JonasNorling/knobbox/hw/knobboard-round/encoders2.sch

## KiCad design hw/knobboard-round/encoders2.sch (2015-05-10)

Schematic: encoders2.sch

Parts:
C23, C25: 100n
C24: 10u
ENC5, ENC6, ENC7, ENC8: PEL12D
RK52, RK53, RK62, RK63, RK72, RK73, RK82, RK83: 390
RPU13, RPU14, RPU15, RPU16, RPU17, RPU18, RPU19, RPU20, RPU21, RPU22, RPU23, RPU24: 20k
U7: 74HCT595
U9: 74HC165

Notes on the sheet:
PEL12D green/red max 30mA. Vf is 3.2/1.95V. Driven at 8mA, resistors should be 225/381 ohms. terminal 2 is green, terminal 3 is red.
NXP 74HCT595 will source up to 8mA to each output and seems to be 5V/3V compatible.
Needs to be 5V/3V compatible --> use HCT
