JonasNorling/knobbox/hw/knobboard-round/encoders3.sch

## KiCad design hw/knobboard-round/encoders3.sch (2015-05-10)

Schematic: encoders3.sch

Parts:
C30, C32: 100n
C31: 10u
ENC9, ENC10, ENC11, ENC12: PEL12D
RK92, RK93, RK102, RK103, RK112, RK113, RK122, RK123: 390
RPU37, RPU38, RPU39, RPU40, RPU41, RPU42, RPU43, RPU44, RPU45, RPU46, RPU47, RPU48: 20k
U13: 74HCT595
U14: 74HC165

Notes on the sheet:
PEL12D green/red max 30mA. Vf is 3.2/1.95V. Driven at 8mA, resistors should be 225/381 ohms. terminal 2 is green, terminal 3 is red.
NXP 74HCT595 will source up to 8mA to each output and seems to be 5V/3V compatible.
Needs to be 5V/3V compatible --> use HCT
