JonasNorling/knobbox/hw/knobboard-round/encoders4.sch

## KiCad design hw/knobboard-round/encoders4.sch (2015-05-10)

Schematic: encoders4.sch

Parts:
C27, C29: 100n
C28: 10u
ENC13, ENC14, ENC15, ENC16: PEL12D
RK132, RK133, RK142, RK143, RK152, RK153, RK162, RK163: 390
RPU25, RPU26, RPU27, RPU28, RPU29, RPU30, RPU31, RPU32, RPU33, RPU34, RPU35, RPU36: 20k
U11: 74HCT595
U12: 74HC165

Notes on the sheet:
PEL12D green/red max 30mA. Vf is 3.2/1.95V. Driven at 8mA, resistors should be 225/381 ohms. terminal 2 is green, terminal 3 is red.
NXP 74HCT595 will source up to 8mA to each output and seems to be 5V/3V compatible.
Needs to be 5V/3V compatible --> use HCT
