JonasNorling/knobbox/hw/knobboard-round/encoders.sch

## KiCad design hw/knobboard-round/encoders.sch (2015-05-10)

Schematic: encoders.sch

Parts:
C6, C11: 100n
C16: 10u
ENC1, ENC2, ENC3, ENC4: PEL12D
RK12, RK13, RK22, RK23, RK32, RK33, RK42, RK43: 390
RPU1, RPU5, RPU6, RPU7, RPU8, RPU9, RPU10, RPU11, RPU12: 20k
U3: 74HCT595
U8: 74HC165

Notes on the sheet:
PEL12D green/red max 30mA. Vf is 3.2/1.95V. Driven at 8mA, resistors should be 225/381 ohms. terminal 2 is green, terminal 3 is red.
NXP 74HCT595 will source up to 8mA to each output and seems to be 5V/3V compatible.
Needs to be 5V/3V compatible --> use HCT
