JonasNorling/knobbox/hw/knobboard-round/flash.sch

## KiCad design hw/knobboard-round/flash.sch (2015-05-10)

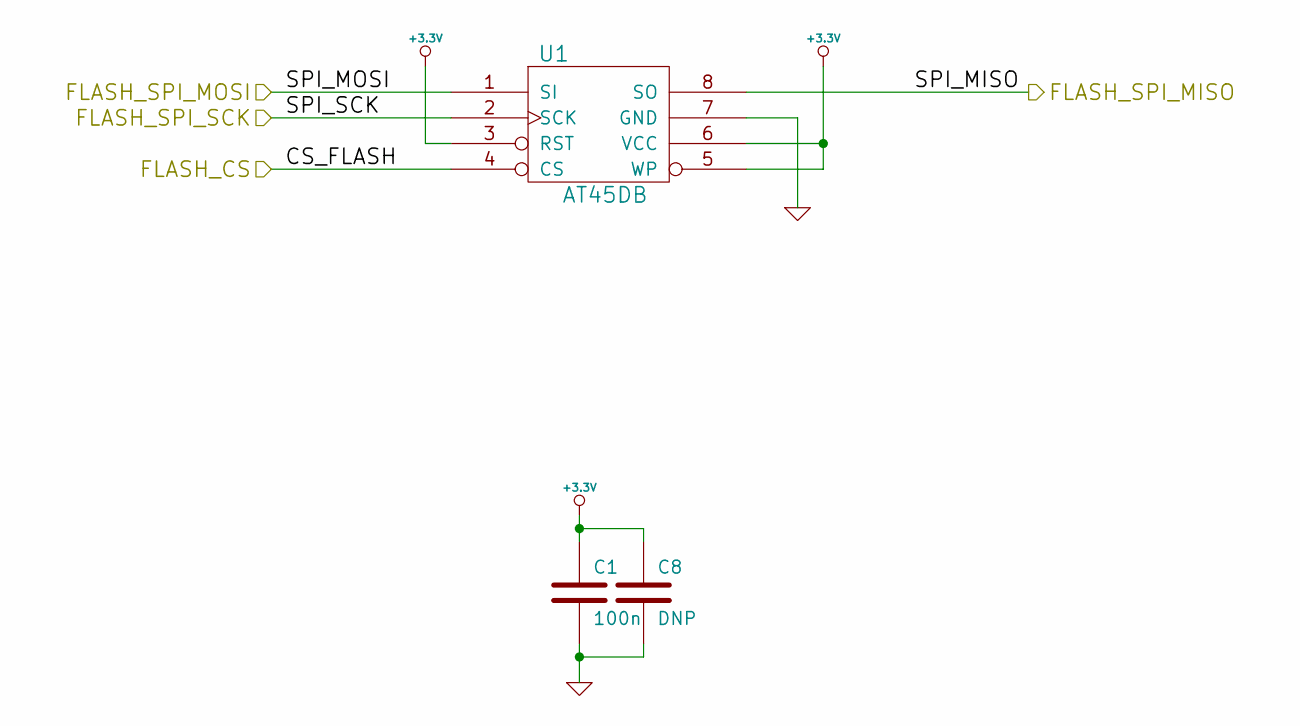
[picture p1: schematic flash.sch]

Parts:
C1: 100n
C8: DNP
U1: AT45DB

Connections:
+3.3V: C1.1, C8.1, U1.3 (RST), U1.5 (WP), U1.6 (VCC)
CS_FLASH: U1.4 (CS)
FLASH_SPI_MISO: U1.8 (SO)
FLASH_SPI_MOSI: U1.1 (SI)
FLASH_SPI_SCK: U1.2 (SCK)
GND: C1.2, C8.2, U1.7 (GND)
