JonasNorling/knobbox/hw/knobboard-round/io.sch

## KiCad design hw/knobboard-round/io.sch (2015-05-10)

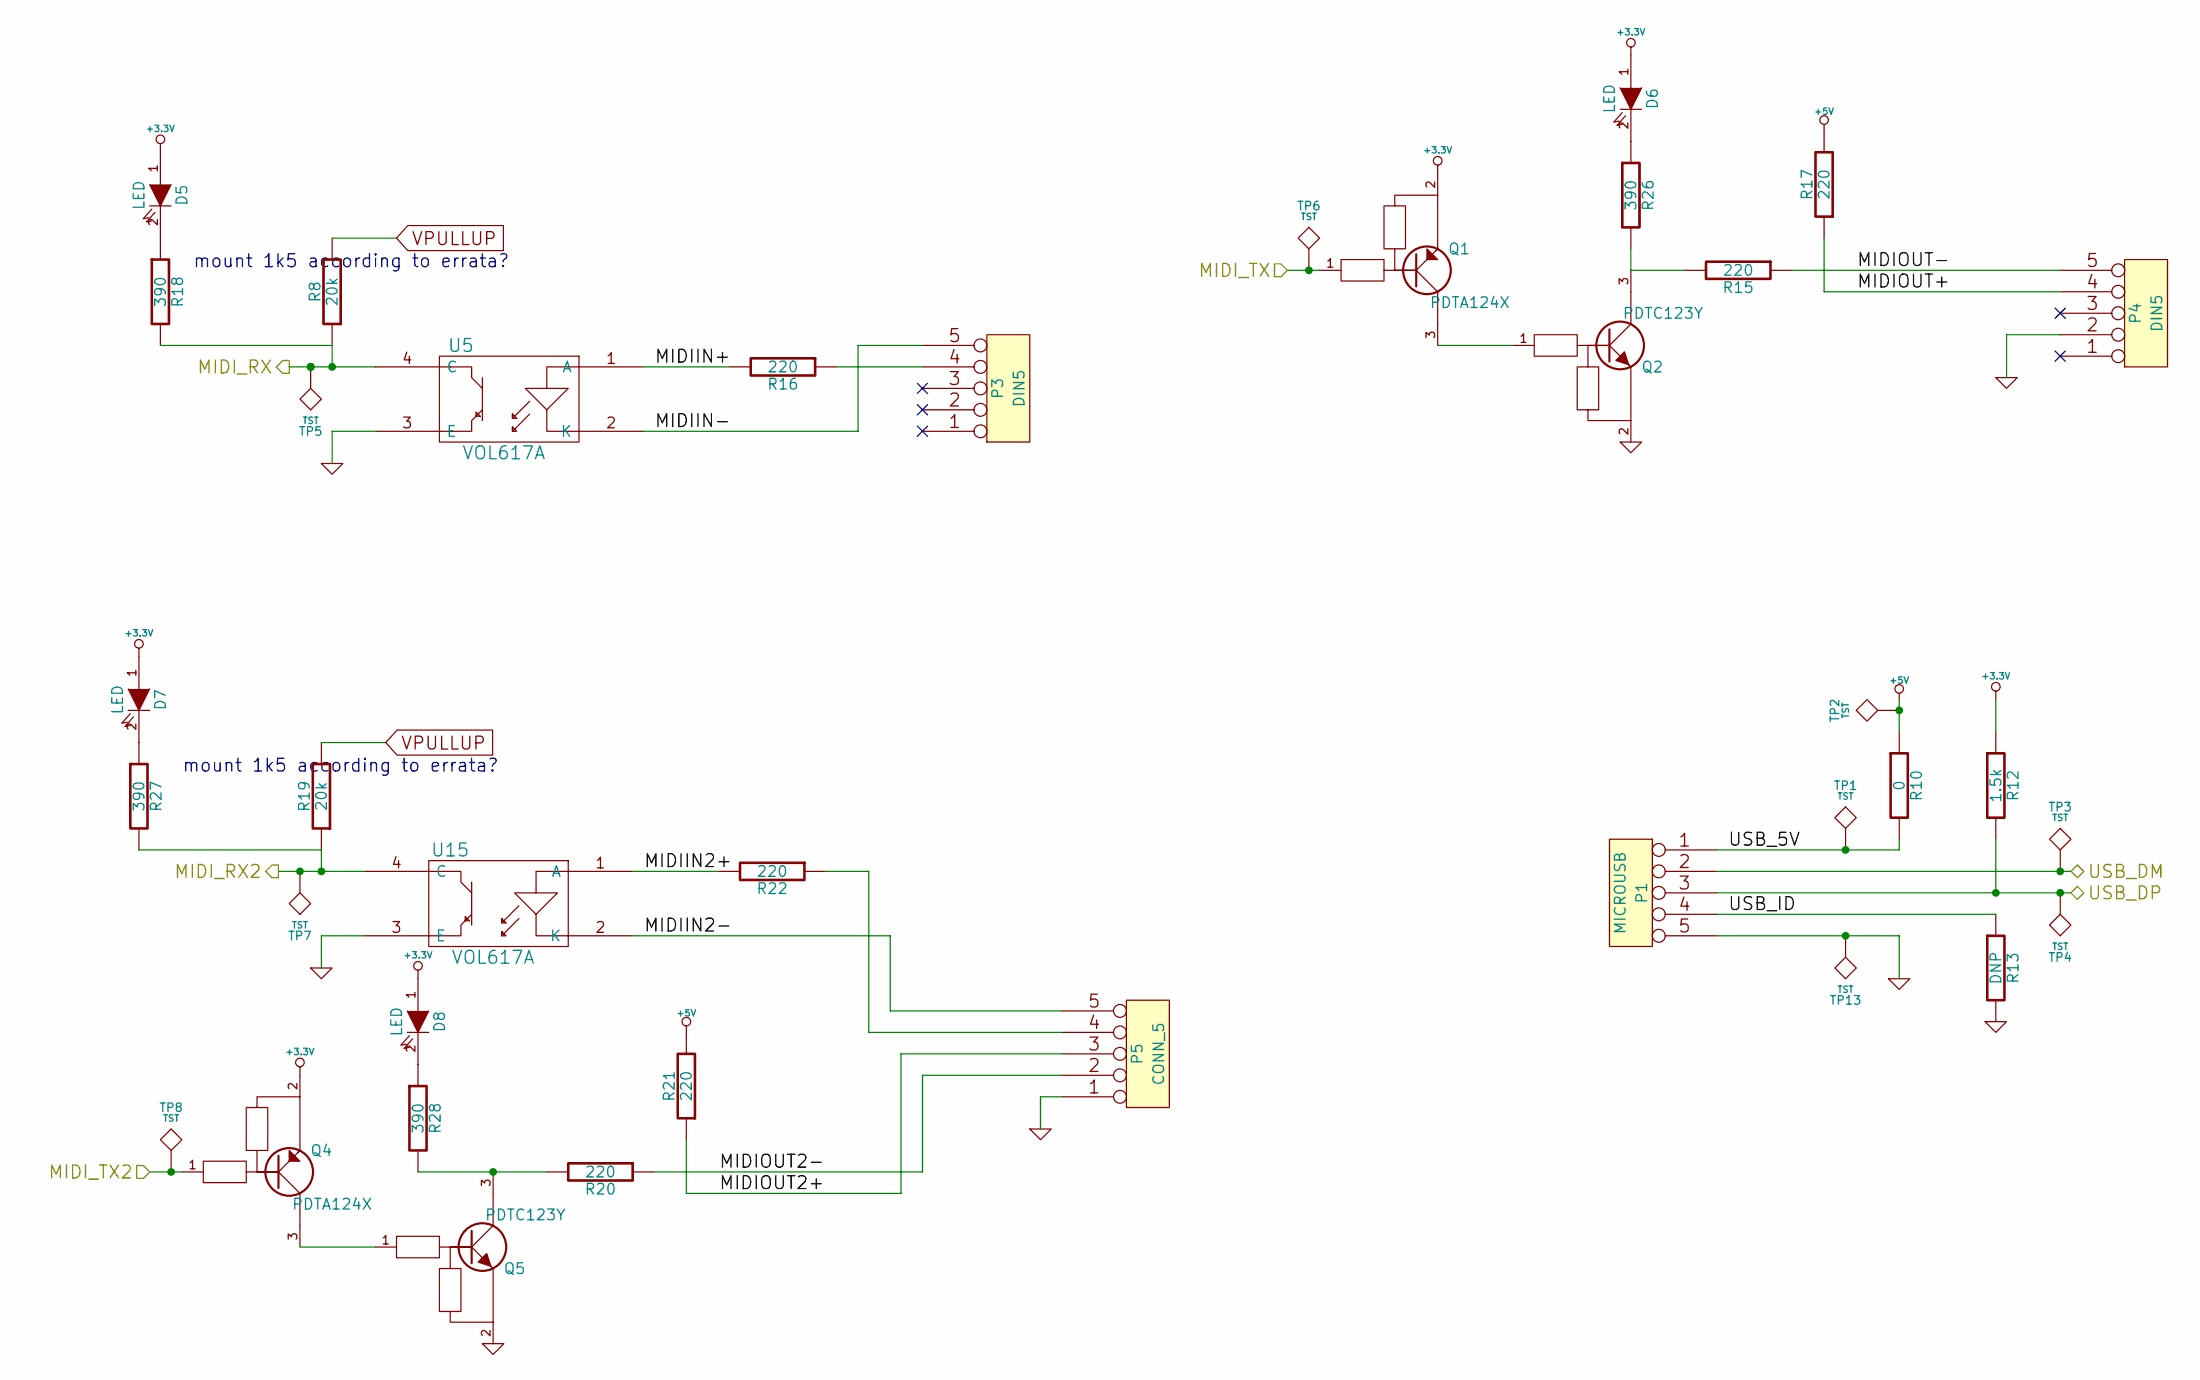
[picture p2: schematic io.sch]

Parts:
D5, D6, D7, D8: LED
P1: MICROUSB
P3, P4: DIN5
P5: CONN_5
Q1, Q4: PDTA124X; SOT23-3
Q2, Q5: PDTC123Y; SOT23-3
R8, R19: 20k
R10: 0
R12: 1.5k
R13: DNP
R15, R16, R17, R20, R21, R22: 220
R18, R26, R27, R28: 390
TP1, TP2, TP3, TP4, TP5, TP6, TP7, TP8, TP13: TST
U5, U15: VOL617A

Connections:
+3.3V: D5.1 (A), D6.1 (A), D7.1 (A), D8.1 (A), Q1.2 (E), Q4.2 (E), R12.1
+5V: R10.1, R17.2, R21.2, TP2.1
GND: P1.5, P4.2, P5.1, Q2.2 (E), Q5.2 (E), R13.2, TP13.1, U5.3 (E), U15.3 (E)
MIDIIN2+: R22.2, U15.1 (A)
MIDIIN2-: P5.5, U15.2 (K)
MIDIIN+: R16.2, U5.1 (A)
MIDIIN-: P3.5, U5.2 (K)
MIDIOUT2+: P5.3, R21.1
MIDIOUT2-: P5.2, R20.1
MIDIOUT+: P4.4, R17.1
MIDIOUT-: P4.5, R15.1
MIDI_RX: R8.1, R18.2, TP5.1, U5.4 (C)
MIDI_RX2: R19.1, R27.2, TP7.1, U15.4 (C)
MIDI_TX: Q1.1 (B), TP6.1
MIDI_TX2: Q4.1 (B), TP8.1
unnamed: D5.2 (K), R18.1
unnamed: D6.2 (K), R26.1
unnamed: D7.2 (K), R27.1
unnamed: D8.2 (K), R28.1
unnamed: P3.4, R16.1
unnamed: P5.4, R22.1
unnamed: Q1.3 (C), Q2.1 (B)
unnamed: Q2.3 (C), R15.2, R26.2
unnamed: Q4.3 (C), Q5.1 (B)
unnamed: Q5.3 (C), R20.2, R28.2
USB_5V: P1.1, R10.2, TP1.1
USB_DM: P1.2, TP3.1
USB_DP: P1.3, R12.2, TP4.1
USB_ID: P1.4, R13.1
VPULLUP: R8.2, R19.2

Notes on the sheet:
mount 1k5 according to errata?
