JonasNorling/knobbox/hw/knobboard-round/knobboard.sch

## KiCad design hw/knobboard-round/knobboard.sch (2015-05-10)

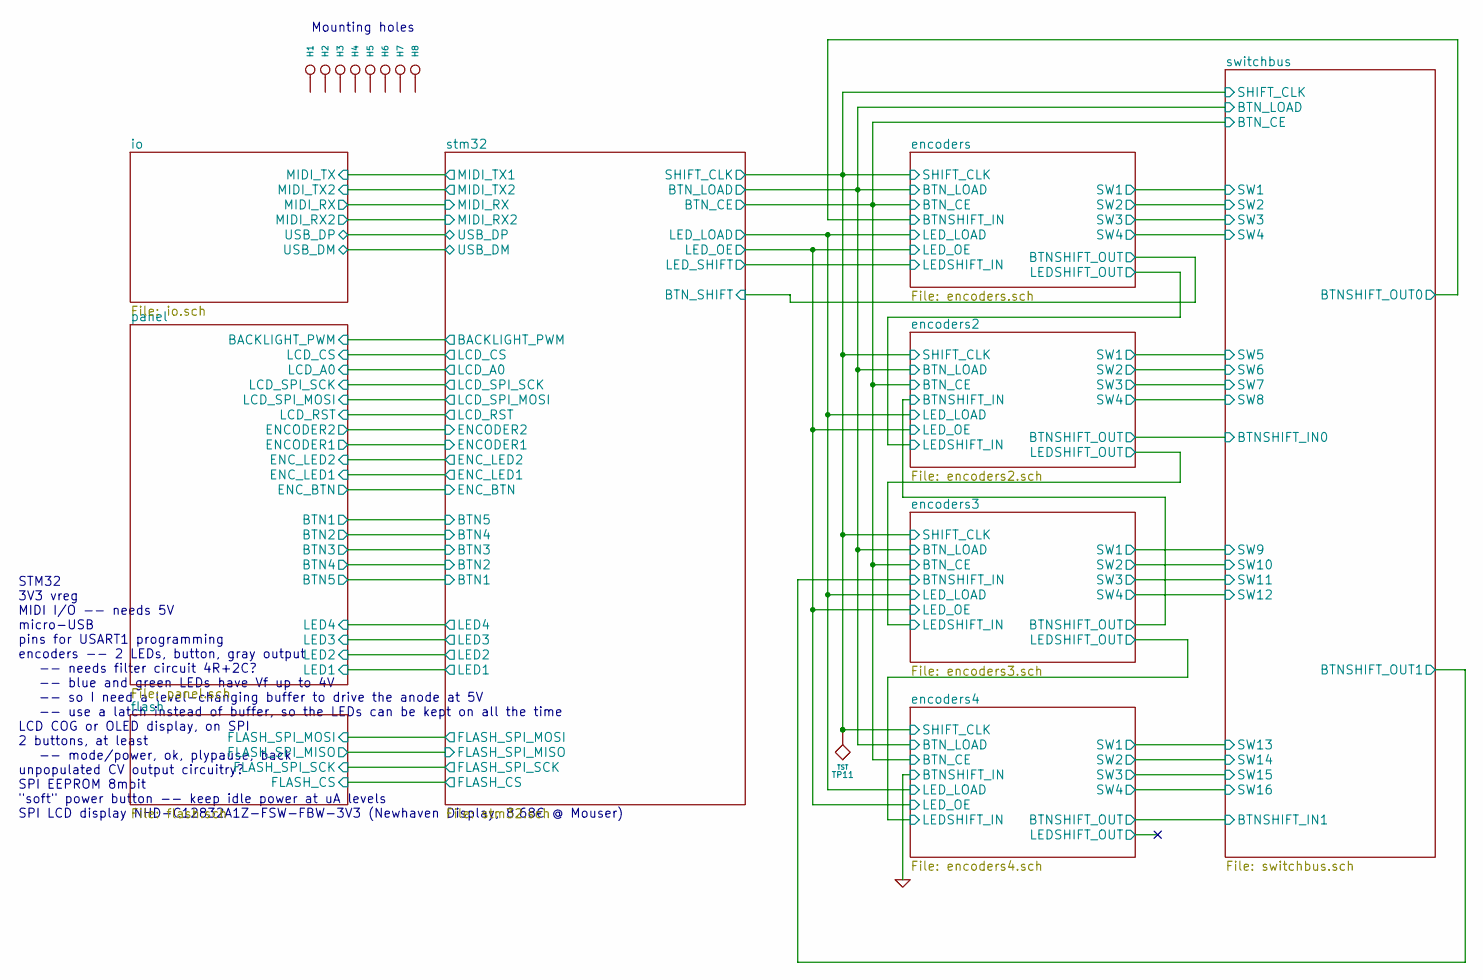
[picture p3: schematic knobboard.sch]

Parts:
H1, H2, H3, H4, H5, H6, H7, H8: CONN_1
TP11: TST

Connections:
SHIFT_CLK: TP11.1

Notes on the sheet:
Mounting holes
STM32 3V3 vreg MIDI I/O -- needs 5V micro-USB pins for USART1 programming encoders -- 2 LEDs, button, gray output -- needs filter circuit 4R+2C? -- blue and green LEDs have Vf up to 4V -- so I need a level-changing buffer to drive the anode at 5V -- use a latch instead of buffer, so the LEDs can be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
