JonasNorling/knobbox/hw/knobboard-round/panel.sch

## KiCad design hw/knobboard-round/panel.sch (2015-05-10)

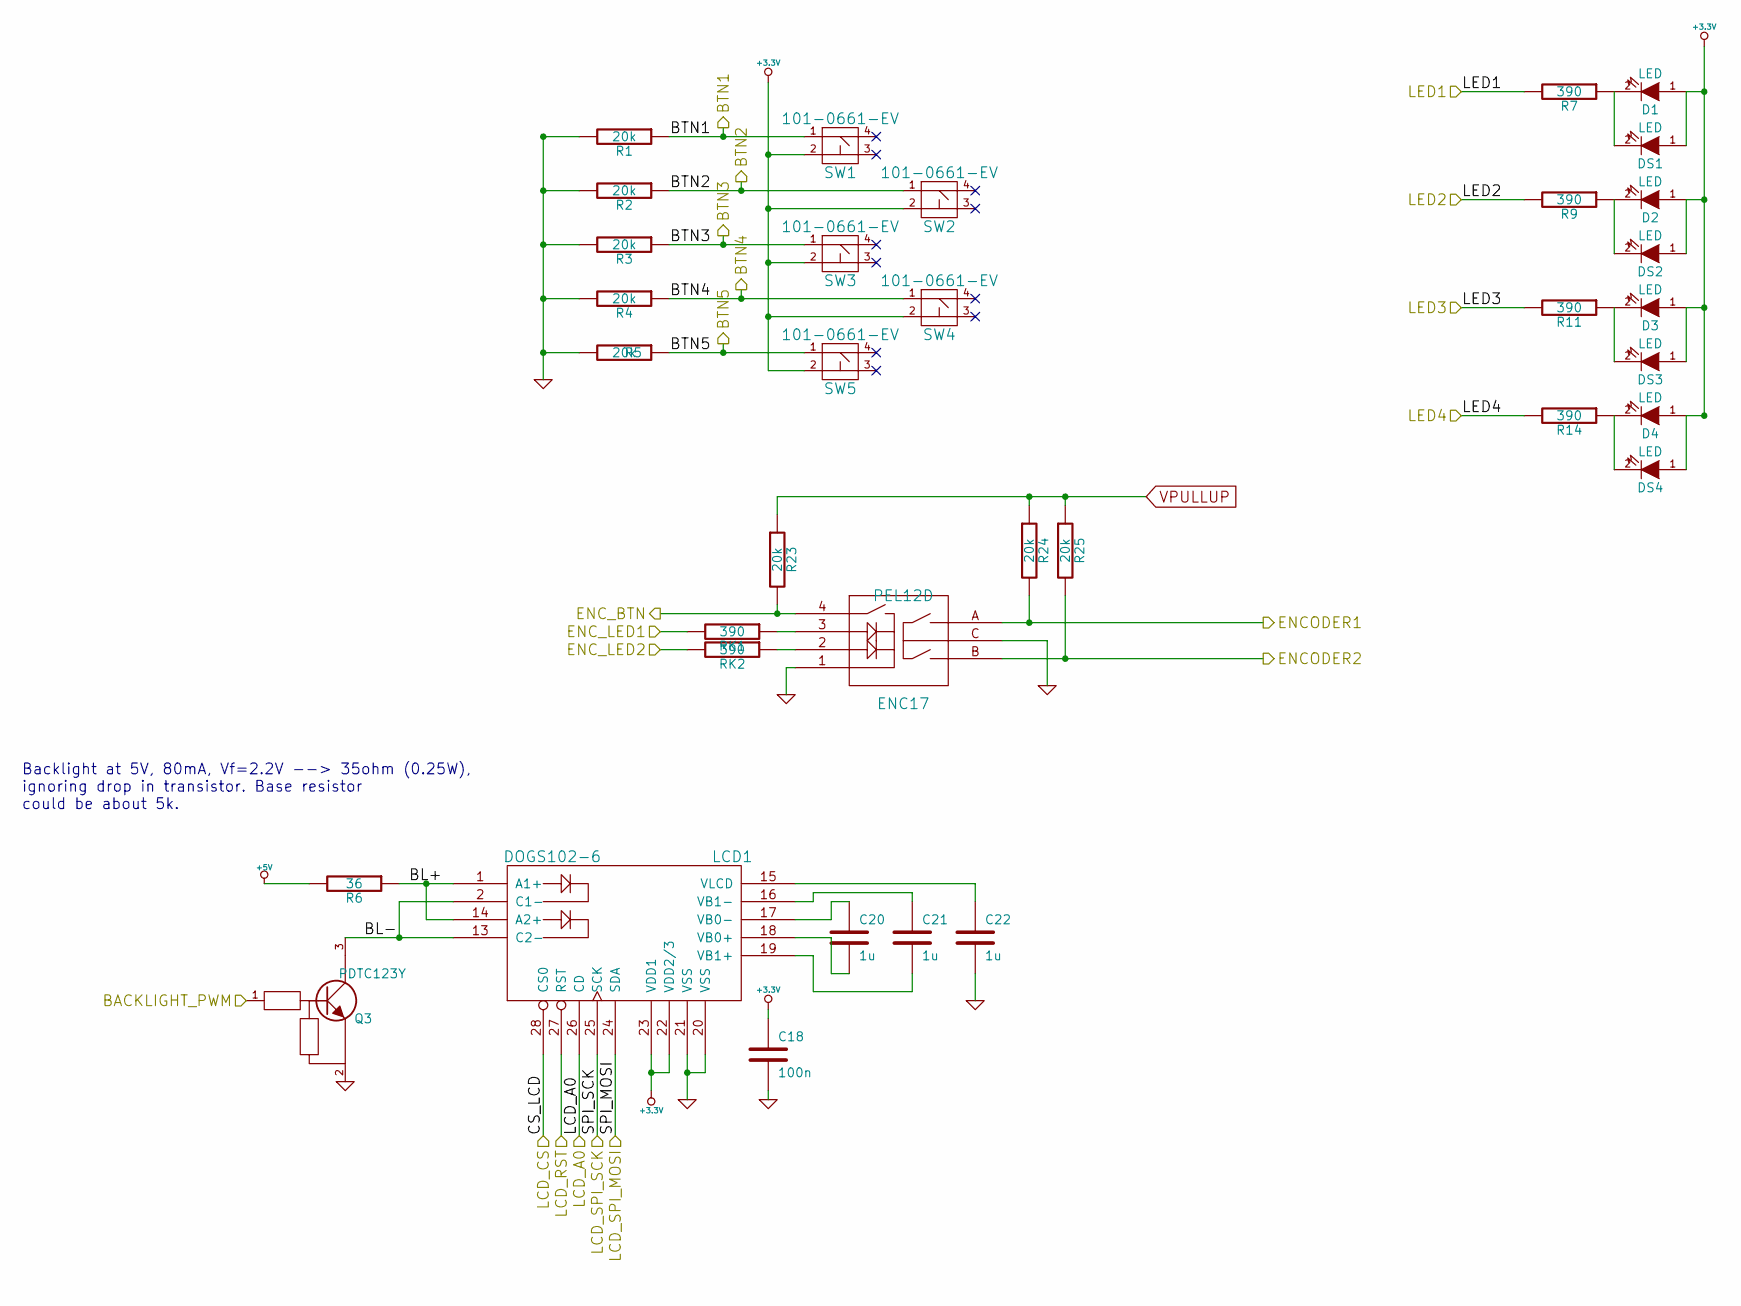
[picture p4: schematic panel.sch]

Parts:
C18: 100n
C20, C21, C22: 1u
D1, D2, D3, D4: LED
DS1, DS2, DS3, DS4: LED
ENC17: PEL12D
LCD1: DOGS102-6
Q3: PDTC123Y; SOT23-3
R1, R2, R3, R4, R5, R23, R24, R25: 20k
R6: 36
R7, R9, R11, R14: 390
RK1, RK2: 390
SW1, SW2, SW3, SW4, SW5: 101-0661-EV

Connections:
+3.3V: C18.1, D1.1 (A), D2.1 (A), D3.1 (A), D4.1 (A), DS1.1 (A), DS2.1 (A), DS3.1 (A), DS4.1 (A), LCD1.22 (VDD2/3), LCD1.23 (VDD1), SW1.2, SW2.2, SW3.2, SW4.2, SW5.2
+5V: R6.2
BACKLIGHT_PWM: Q3.1 (B)
BL+: LCD1.1 (A1+), LCD1.14 (A2+), R6.1
BL-: LCD1.2 (C1-), LCD1.13 (C2-), Q3.3 (C)
BTN1: R1.1, SW1.1
BTN2: R2.1, SW2.1
BTN3: R3.1, SW3.1
BTN4: R4.1, SW4.1
BTN5: R5.1, SW5.1
CS_LCD: LCD1.28 (CS0)
ENCODER1: ENC17.A, R24.2
ENCODER2: ENC17.B, R25.2
ENC_BTN: ENC17.4 (sw), R23.2
ENC_LED1: RK1.2
ENC_LED2: RK2.2
GND: C18.2, C22.2, ENC17.1 (common), ENC17.C, LCD1.20 (VSS), LCD1.21 (VSS), Q3.2 (E), R1.2, R2.2, R3.2, R4.2, R5.2
LCD_A0: LCD1.26 (CD)
LCD_RST: LCD1.27 (RST)
LCD_SPI_MOSI: LCD1.24 (SDA)
LCD_SPI_SCK: LCD1.25 (SCK)
LED1: R7.2
LED2: R9.2
LED3: R11.2
LED4: R14.2
unnamed: C20.1, LCD1.17 (VB0-)
unnamed: C20.2, LCD1.18 (VB0+)
unnamed: C21.1, LCD1.16 (VB1-)
unnamed: C21.2, LCD1.19 (VB1+)
unnamed: C22.1, LCD1.15 (VLCD)
unnamed: D1.2 (K), DS1.2 (K), R7.1
unnamed: D2.2 (K), DS2.2 (K), R9.1
unnamed: D3.2 (K), DS3.2 (K), R11.1
unnamed: D4.2 (K), DS4.2 (K), R14.1
unnamed: ENC17.2 (anode), RK2.1
unnamed: ENC17.3 (anode), RK1.1
VPULLUP: R23.1, R24.1, R25.1

Notes on the sheet:
Backlight at 5V, 80mA, Vf=2.2V --> 35ohm (0.25W), ignoring drop in transistor. Base resistor could be about 5k.
