JonasNorling/knobbox/hw/knobboard-round/stm32.sch

## KiCad design hw/knobboard-round/stm32.sch (2015-05-10)

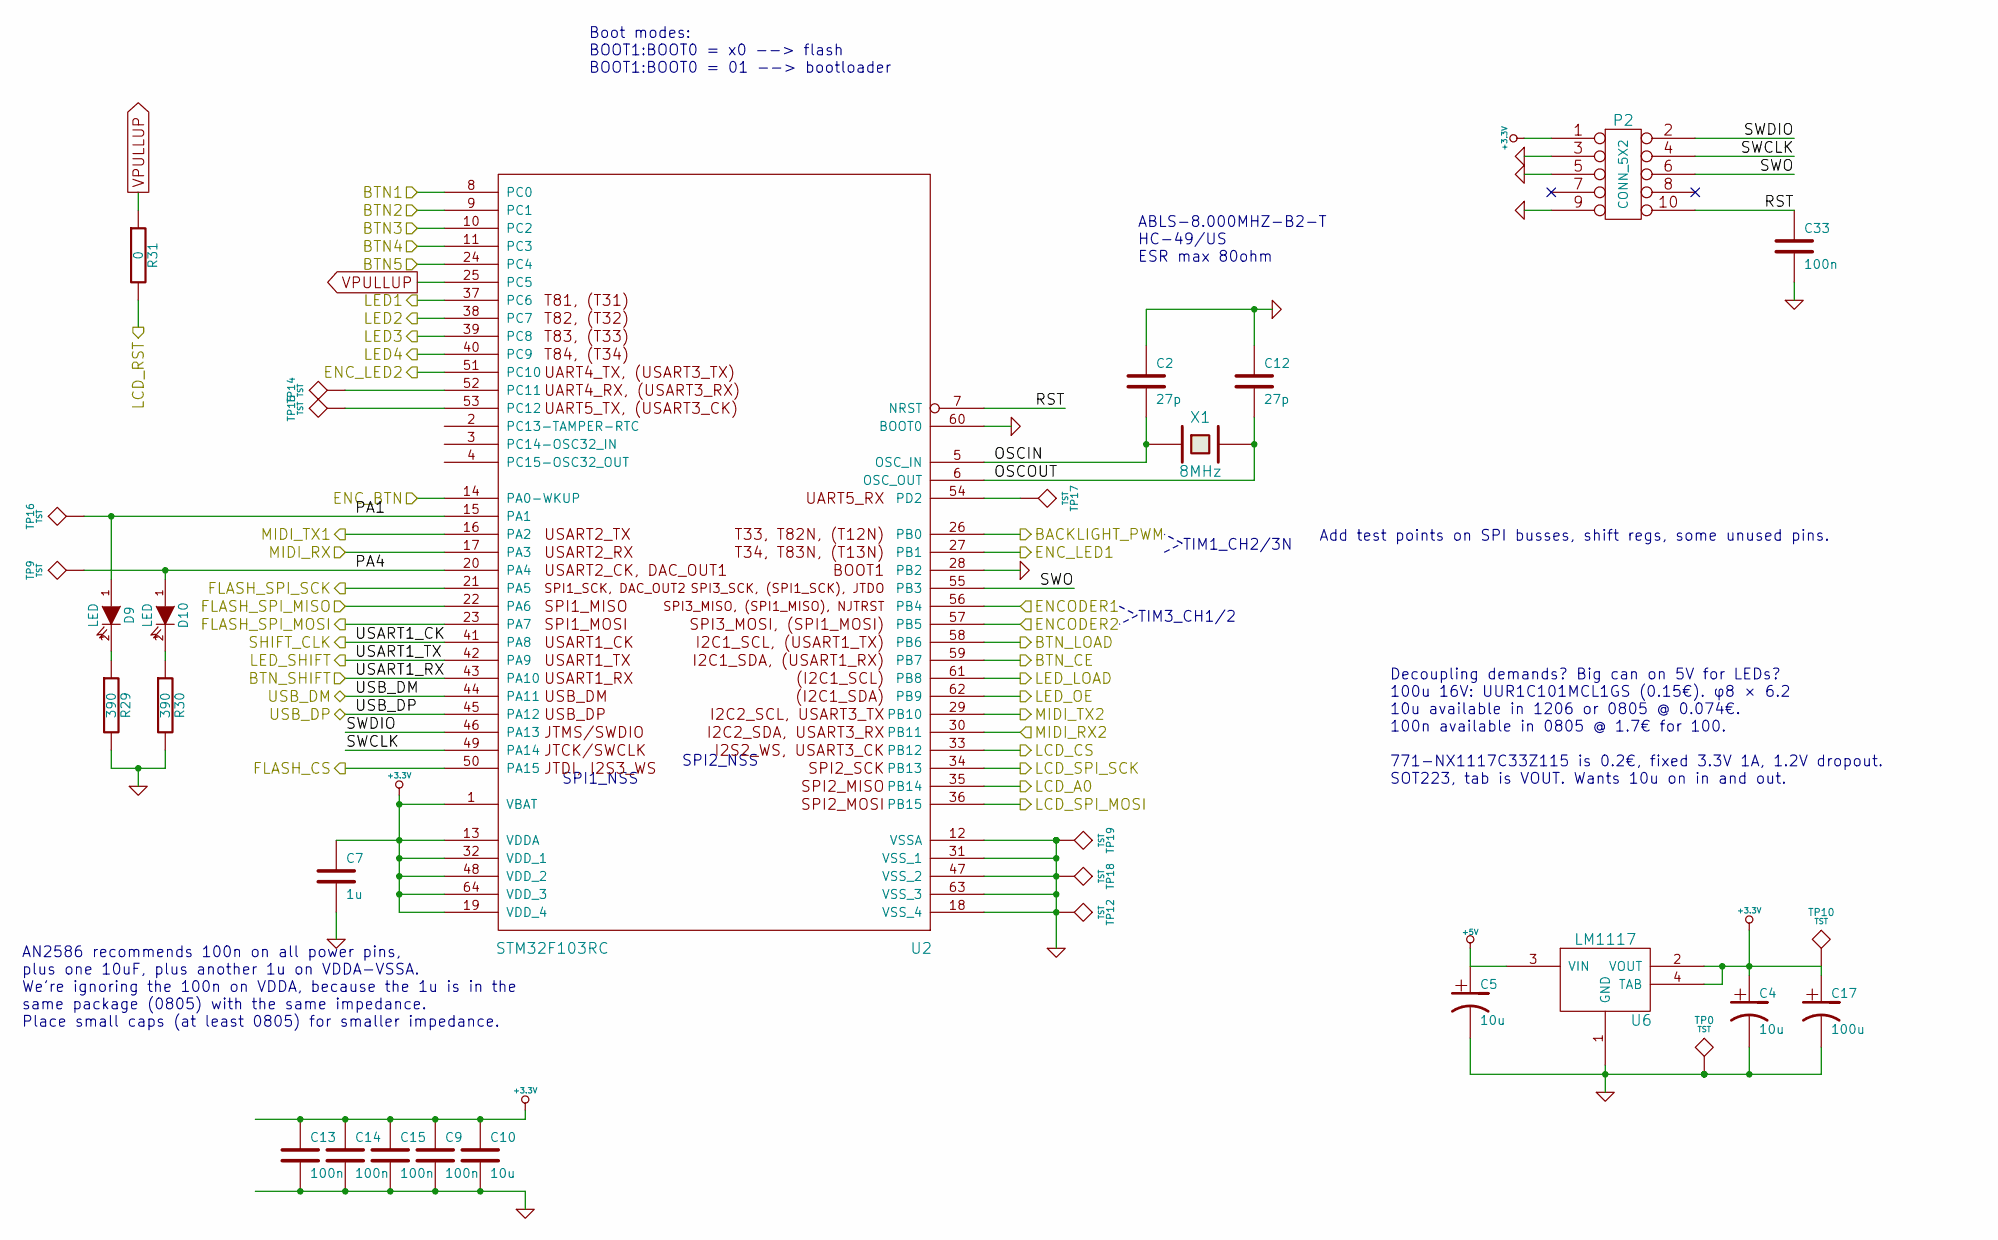
[picture p5: schematic stm32.sch]

Parts:
C2, C12: 27p
C4, C5, C10: 10u
C7: 1u
C9, C13, C14, C15, C33: 100n
C17: 100u
D9, D10: LED
P2: CONN_5X2
R29, R30: 390
R31: 0
TP0, TP9, TP10, TP12, TP14, TP15, TP16, TP17, TP18, TP19: TST
U2: STM32F103RC
U6: LM1117
X1: 8MHz

Connections:
+3.3V: C4.1, C7.1, C9.1, C10.1, C13.1, C14.1, C15.1, C17.1, P2.1, TP10.1, U2.1 (VBAT), U2.13 (VDDA), U2.19 (VDD_4), U2.32 (VDD_1), U2.48 (VDD_2), U2.64 (VDD_3), U6.2 (VOUT), U6.4 (TAB)
+5V: C5.1, U6.3 (VIN)
BACKLIGHT_PWM: U2.26 (PB0)
BTN1: U2.8 (PC0)
BTN2: U2.9 (PC1)
BTN3: U2.10 (PC2)
BTN4: U2.11 (PC3)
BTN5: U2.24 (PC4)
BTN_CE: U2.59 (PB7)
BTN_LOAD: U2.58 (PB6)
BTN_SHIFT: U2.43 (PA10)
ENCODER1: U2.56 (PB4)
ENCODER2: U2.57 (PB5)
ENC_BTN: U2.14 (PA0-WKUP)
ENC_LED1: U2.27 (PB1)
ENC_LED2: U2.51 (PC10)
FLASH_CS: U2.50 (PA15)
FLASH_SPI_MISO: U2.22 (PA6)
FLASH_SPI_MOSI: U2.23 (PA7)
FLASH_SPI_SCK: U2.21 (PA5)
GND: C2.1, C4.2, C5.2, C7.2, C9.2, C10.2, C12.1, C13.2, C14.2, C15.2, C17.2, C33.2, P2.3, P2.5, P2.9, R29.2, R30.2, TP0.1, TP12.1, TP18.1, TP19.1, U2.12 (VSSA), U2.18 (VSS_4), U2.28 (PB2), U2.31 (VSS_1), U2.47 (VSS_2), U2.60 (BOOT0), U2.63 (VSS_3), U6.1 (GND)
LCD_A0: U2.35 (PB14)
LCD_CS: U2.33 (PB12)
LCD_RST: R31.2
LCD_SPI_MOSI: U2.36 (PB15)
LCD_SPI_SCK: U2.34 (PB13)
LED1: U2.37 (PC6)
LED2: U2.38 (PC7)
LED3: U2.39 (PC8)
LED4: U2.40 (PC9)
LED_LOAD: U2.61 (PB8)
LED_OE: U2.62 (PB9)
LED_SHIFT: U2.42 (PA9)
MIDI_RX: U2.17 (PA3)
MIDI_RX2: U2.30 (PB11)
MIDI_TX1: U2.16 (PA2)
MIDI_TX2: U2.29 (PB10)
unnamed: D9.2 (K), R29.1
unnamed: D10.2 (K), R30.1
unnamed: TP14.1, U2.52 (PC11)
unnamed: TP15.1, U2.53 (PC12)
unnamed: TP17.1, U2.54 (PD2)
OSCIN: C2.2, U2.5 (OSC_IN), X1.1
OSCOUT: C12.2, U2.6 (OSC_OUT), X1.2
PA1: D9.1 (A), TP16.1, U2.15 (PA1)
PA4: D10.1 (A), TP9.1, U2.20 (PA4)
RST: C33.1, P2.10, U2.7 (NRST)
SHIFT_CLK: U2.41 (PA8)
SWCLK: P2.4, U2.49 (PA14)
SWDIO: P2.2, U2.46 (PA13)
SWO: P2.6, U2.55 (PB3)
USB_DM: U2.44 (PA11)
USB_DP: U2.45 (PA12)
VPULLUP: R31.1, U2.25 (PC5)

Notes on the sheet:
Add test points on SPI busses, shift regs, some unused pins.
TIM3_CH1/2
TIM1_CH2/3N
SPI2_NSS
SPI1_NSS
ABLS-8.000MHZ-B2-T HC-49/US ESR max 80ohm
AN2586 recommends 100n on all power pins, plus one 10uF, plus another 1u on VDDA-VSSA. We're ignoring the 100n on VDDA, because the 1u is in the same package (0805) with the same impedance. Place small caps (at least 0805) for smaller impedance.
Decoupling demands? Big can on 5V for LEDs? 100u 16V: UUR1C101MCL1GS (0.15€). φ8 × 6.2 10u available in 1206 or 0805 @ 0.074€. 100n available in 0805 @ 1.7€ for 100. 771-NX1117C33Z115 is 0.2€, fixed 3.3V 1A, 1.2V dropout. SOT223, tab is VOUT. Wants 10u on in and out.
Boot modes: BOOT1:BOOT0 = x0 --> flash BOOT1:BOOT0 = 01 --> bootloader
