JonasNorling/knobbox/hw/knobboard-round/switchbus.sch

## KiCad design hw/knobboard-round/switchbus.sch (2015-05-10)

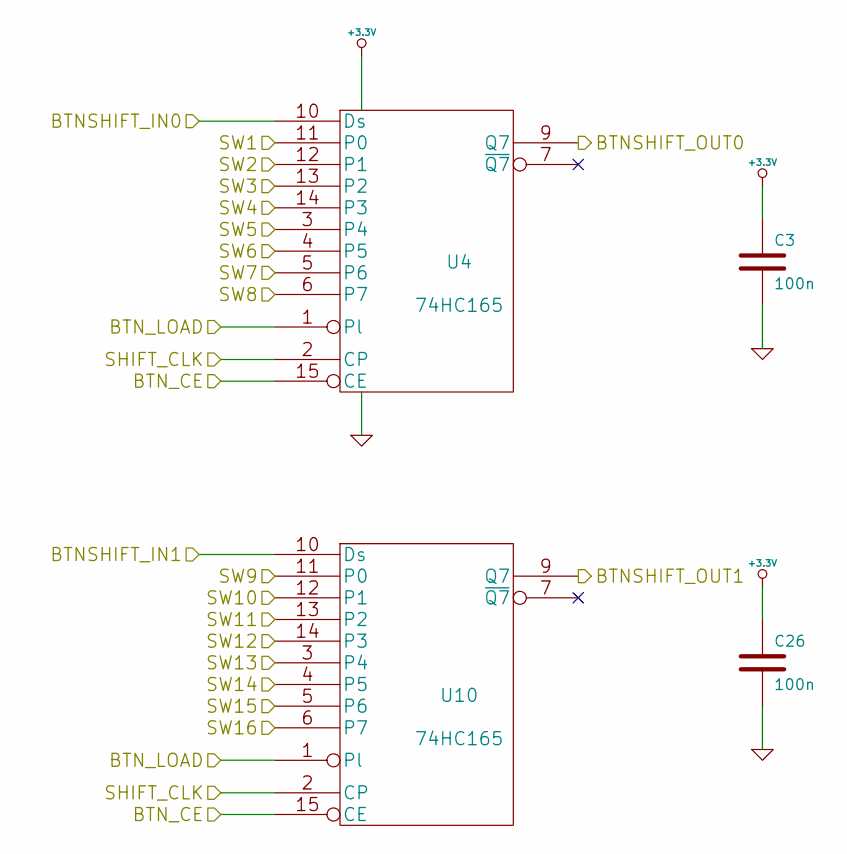
[picture p6: schematic switchbus.sch]

Parts:
C3, C26: 100n
U4, U10: 74HC165

Connections:
+3.3V: C3.1, C26.1, U4.16 (VCC)
BTNSHIFT_IN0: U4.10 (Ds)
BTNSHIFT_IN1: U10.10 (Ds)
BTNSHIFT_OUT0: U4.9 (Q7)
BTNSHIFT_OUT1: U10.9 (Q7)
BTN_CE: U4.15 (CE), U10.15 (CE)
BTN_LOAD: U4.1 (Pl), U10.1 (Pl)
GND: C3.2, C26.2, U4.8 (GND)
SHIFT_CLK: U4.2 (CP), U10.2 (CP)
SW1: U4.11 (P0)
SW2: U4.12 (P1)
SW3: U4.13 (P2)
SW4: U4.14 (P3)
SW5: U4.3 (P4)
SW6: U4.4 (P5)
SW7: U4.5 (P6)
SW8: U4.6 (P7)
SW9: U10.11 (P0)
SW10: U10.12 (P1)
SW11: U10.13 (P2)
SW12: U10.14 (P3)
SW13: U10.3 (P4)
SW14: U10.4 (P5)
SW15: U10.5 (P6)
SW16: U10.6 (P7)
