JonasNorling/knobbox/fw/src/TControllerPage.cpp

#include "TControllerPage.h"
#include "TGui.h"
#include "TSequencer.h"
#include "TControllers.h"
#include "utils.h"

void TControllerPage::Show()
{
    Gui.UpdateAll();
    Controllers.UpdateKnobs();

    while (true) {
        TEvent event = Gui.WaitForEvent();

        switch (event_code(event)) {
        case RENDER_LINE: {
            const uint8_t n = event_value(event);
            TDisplay::TPageBuffer* line = Display.GetBuffer();
            if (line) {
                line->Clear();
                if (n == 0) {
                    TopMenu.Render(n, line, Focus == FOCUS_TOP_MENU);
                }
                else {
                    Render(n, line);
                }
                Display.OutputBuffer(line, line->GetLength(), n, 0);
            }
            else {
                Gui.UpdateLine(n); // Try again
            }
            break;
        }

        case KEY_DOWN:
            if (Focus < FOCUS_LAST) Focus++;
            Gui.UpdateAll();
            break;

        case KEY_UP:
            if (Focus > FOCUS_TOP_MENU) Focus--;
            Gui.UpdateAll();
            break;

        case KEY_OK:
            switch (Focus) {
            case FOCUS_TOP_MENU:
                TopMenu.Event(event);
                return;
            case FOCUS_CHANNEL: {
                TChannelSelectPopup popup;
                int channel = popup.Show(CurrentChannel);
                if (channel != -1) CurrentChannel = channel;
                Gui.UpdateAll();
                break;
            }
            case FOCUS_SCENE: {
                //TSceneSelectPopup popup;
                //popup.Show();
                TChannelSelectPopup popup;
                popup.Show(CurrentChannel);
                Gui.UpdateAll();
                break;
            }
            }
            break;

            case KEY_BACK:
                switch (Focus) {
                case FOCUS_TOP_MENU:
                    TopMenu.Event(event);
                    return;
                }
                break;
        }
    }
}

void TControllerPage::Render(uint8_t n, TDisplay::TPageBuffer* line)
{
    const int currentKnob = Controllers.GetActiveKnob();
    const uint8_t currentValue = Controllers.GetValue(currentKnob);

    if (n == 1) {
        char channel[4];
        channel[0] = '\037';
        channel[1] = '0' + CurrentChannel + 1;
        channel[2] = ' ';
        channel[3] = '\0';
        uint8_t pos = line->DrawText(channel, LeftMargin, Focus == FOCUS_CHANNEL);
        line->DrawText(Controllers.GetScene().Name, pos, Focus == FOCUS_SCENE);
    }
    else if (n == 2) {
        line->DrawText("clock ON  seq ON", LeftMargin);
    }
    else if (n == 3) {
        const int barstart = 18;
        int i = -1;
        line->Data[barstart+i] = 0x7e;
        for (; i < currentValue / 2; i++) {
            line->Data[barstart+i] = 0x7e;
        }
        for (; i < 64; i++) {
            line->Data[barstart+i] = 0x42;
        }
        line->Data[barstart+i] = 0x7e;
    }
    else if (n == 4) {
        char text[20];
        cheap_strcpy(text, "\036knob xx: xxx");
        render_uint(text+6, currentKnob + 1, 2);
        render_uint(text+10, currentValue, 3);
        line->DrawText(text, LeftMargin);
    }
    else if (n == 5) {
        char text[20];
        cheap_strcpy(text, "\036\037xx ");
        render_uint(text+2, Controllers.GetScene().Knobs[currentKnob].Channel + 1, 2);
        cheap_strcpy(text+5, Controllers.GetScene().Knobs[currentKnob].InstrumentName);
        line->DrawText(text, LeftMargin);
    }
    else if (n == 6) {
        char text[20];
        cheap_strcpy(text, "\036CCxx ");
        render_uint(text+3, Controllers.GetScene().Knobs[currentKnob].Param, 2);
        cheap_strcpy(text+6, Controllers.GetScene().Knobs[currentKnob].Name);
        line->DrawText(text, LeftMargin);
    }
    else if (n == 7) {
        line->Invert(0, line->GetLength());
    }
}

void TChannelSelectPopup::GetMenuTitle(char text[MenuTextLen])
{
    cheap_strcpy(text, "MIDI channel");
}

void TChannelSelectPopup::GetMenuItem(uint8_t n, char text[MenuTextLen])
{
    if (n > 15) return;
    const char* channel = "Channel \037";
    size_t i = cheap_strcpy(text, channel);
    text[i++] = ' ';
    text[i++] = '0' + n + 1;
    text[i++] = '\0';
}
