JonasNorling/knobbox/fw/src/TSpiDmaJob.h

/* -*- c++ -*-
 */
#pragma once
#include <cstdint>
#include "device.h"
#include "TCircularBuffer.h"
#include "TBuffer.h"
#include "TScheduler.h"

class TBuffer;

class TBlockingSpiDmaJob
{
public:
    TBlockingSpiDmaJob(const uint8_t* out, uint8_t* in, int len);
    void Run();
    static void FinishedFromIsr() {
        assert(CurrentJob);
        CurrentJob->Finished = true;
        TScheduler::Wake(CurrentJob->TaskId);
        CurrentJob = 0;
    }

private:
    const uint8_t* Out;
    uint8_t* In;
    int Len;
    int TaskId;
    volatile bool Finished;
    static TBlockingSpiDmaJob* CurrentJob;
};

class IDmaCallback
{
public:
  virtual void DmaFinished(void* context) = 0;
};

class TSpiDmaJob
{
public:
  enum TChip {
    CS_FLASH_START =   0x01,
    CS_FLASH_END =     0x02,
    CS_FLASH_ONESHOT = 0x03,
    CS_LCD =           0x04
  };
  enum TLcdCd {
    LCD_CONTROL = 0,
    LCD_DATA = 1
  };

  TSpiDmaJob() {}

  TSpiDmaJob(const TBuffer& buffer,
	     TChip chip,
	     TLcdCd lcdCd,
	     IDmaCallback* callback = 0,
	     void* context = 0) :
    Buffer(buffer),
    Callback(callback),
    Context(context),
    Bits((chip << 1) | lcdCd)
  { }

  void Finished() const;
  const TBuffer& GetBuffer() const { return Buffer; }
  TChip GetChip() const { return static_cast<TChip>(Bits >> 1); }
  TLcdCd GetLcdData() const { return static_cast<TLcdCd>(Bits & 1); }

private:
  TBuffer Buffer;
  IDmaCallback* Callback;
  void* Context;
  uint8_t Bits;
};

class TSpiDmaQueue
{
public:
  TSpiDmaQueue();
  
  bool Enqueue(const TSpiDmaJob& job);
  bool TryStartJob();

  /** Called when interrupt is received. */
  void Finished()
  {
    TSpiDmaJob job = Jobs.First();
    Jobs.Remove();

    Pin_lcd_cs.Set();

    job.Finished();
  }

private:
  // Max jobs needed: 2 for each TDisplay buffer + 2 for each flash
  // operation
  static const int MaxJobs = 6;
  TCircularBuffer<TSpiDmaJob, MaxJobs> Jobs;
};

extern TSpiDmaQueue SpiDmaQueue;
