JonasNorling/knobbox/(commit log)

2012-04-07 STM32 knob board start
    [encoders.sch, knobboard.brd, knobboard.sch, stm32.sch]
2012-04-10 Display and crystal.
    [encoders.sch, io.sch, knobboard.brd, knobboard.sch, stm32.sch, switchbus.sch]
2012-04-14 Package updates
    [encoders.sch, io.sch, knobboard.brd, knobboard.sch, stm32.sch, switchbus.sch]
2012-04-15 Some escape routing
    [knobboard.brd]
2012-04-17 Switch to shift registers. Routing.
    [encoders.sch, io.sch, knobboard.brd, knobboard.sch, stm32.sch, switchbus.sch]
2012-04-20 Add holes
    [encoders.sch, encoders2.sch, io.sch, knobboard.brd, knobboard.sch, stm32.sch, switchbus.sch]
2012-04-21 Add last encoders
    [encoders2.sch, encoders3.sch, encoders4.sch, io.sch, knobboard.brd, knobboard.sch, stm32.sch, switchbus.sch]
2012-04-22 Minor updates
    [knobboard.brd]
2012-04-26 Add build for host. More DMA work.
2012-04-28 Silkscreen updates. Optimisation
    [encoders.sch, encoders2.sch, encoders3.sch, encoders4.sch, io.sch, knobboard.brd, knobboard.sch, stm32.sch]
2012-04-29 Minor board fiddling
    [knobboard.brd]
2012-04-29 Parred down board to 4 encoders.
    [encoders.sch, io.sch, knobboard.brd, knobboard.sch, stm32.sch, switchbus.sch]
2012-05-01 Minor re-route
    [knobboard.brd]
2012-05-03 Update footprints to match reality
    [knobboard.brd]
2012-05-04 Changes to actually make stuff work. SPI DMA works once, then crashes. There seems to be a problem with the vtable for Display.
    [TCircularBuffer.h, TDisplay.cpp, TDisplay.h, TSpiDmaJob.cpp, TSpiDmaJob.h, main.cpp]
2012-05-05 Add display reset line, since tests show that it's needed.
    [encoders.sch, io.sch, knobboard.brd, knobboard.sch, stm32.sch, switchbus.sch]
2012-05-06 Pin mapping struct
2012-05-06 Change JTAG to SWD.
    [knobboard.brd]
2012-05-06 Silkscren, minor routing.
    [knobboard.brd]
2012-05-06 Systick timer
2012-05-07 This PCB revision was sent to production
    [encoders.sch, io.sch, knobboard.brd, knobboard.sch, stm32.sch, switchbus.sch]
2012-05-08 Button scanning.
2012-05-13 Sequencer timer tick
2012-05-16 Memory, GUI, interrupt prios
2012-05-17 Reset more peripherals at start. Read encoder inputs, partial implementation.
    [TControllerPage.cpp, TControllers.cpp, TControllers.h, TKnobs.cpp, TKnobs.h, main.cpp, utils.h]
2012-05-17 Some trivial page switching logic
2012-05-19 Break apart host and stm32 header stuff
2012-05-22 USART1 DMA optimisation. Increase shift rate to 1MHz. There is something funny going on when reloading the software without doing a hard reset.
    [TKnobs.cpp, TKnobs.h, TMidi.h, main.cpp]
2012-05-24 Move PWM recalculation -- increases update frequency
2012-05-31 Runs on the real board.
2012-06-01 Button polarity on real board.
2012-06-02 Reading encoders, sending CC data.
2012-06-04 Global mode. Basic sequencer implementation. Encoder reading.
2012-06-04 Communicate with the flash memory. Redesign SPI to be RX driven, which made it a bit flaky.
    [TControllerPage.cpp, TMemory.cpp, TMemory.h, TSpiDmaJob.cpp, main.cpp, utils.h]
2012-06-23 Move USB structs to C code for easier initialization. USB actually registers with Linux and pops up as an ALSA device. Requires patched libopencm3, and the IN endpoint has the extra descriptor disabl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
2012-06-23 Fix descriptor. Listen to OUT EP and increment controller 0 on data.
    [TUsb.cpp, TUsb.h]
2012-06-23 Relay some data from USB to MIDI OUT.
2012-06-25 Improve sequencer documentation/plan. Implement stupid step sequencer with (broken) support for offset and length. Blink LEDs in funnier ways.
    [TMemory.h, TSequencer.cpp, TSequencer.h]
2012-06-26 Value clamping. Nicer value printouts.
2012-07-10 Put sequencer events in a linked list, precalculated when changes occur. This has not been tested in the real system. Issues remain.
    [TSequencer.cpp, TSequencer.h]
2012-07-14 Fix some sequencer bugs. More remain.
    [TSequencer.cpp, TSequencer.h, main.cpp]
2012-07-19 Load/save slot menu for sequencer scenes. Scatter-fetch names from flash. Something is fishy, it doesn't work solidly.
    [TMemory.cpp, TMemory.h, TPopup.cpp, TSeqPage.cpp, TSeqPage.h, utils.h]
2012-11-25 Fix flash write bug (it was a problem in the state machine). Flash test program. Cleaning up.
    [TBitmask.h, TCircularBuffer.h, TDisplay.cpp, TFlashTest.cpp, TFlashTest.h, TGui.cpp, TGui.h, TMemory.cpp]
2012-12-02 Simple context switching scheduler.
2012-12-09 Add knob test. Fix bug with knob shift on soft boot -- DMA interrupts were pending.
    [TKnobs.cpp, knobtest.cpp, main.cpp]
2012-12-15 Round knob board.
    [encoders.sch, encoders2.sch, encoders3.sch, encoders4.sch, io.sch, knobboard.brd, knobboard.sch, stm32.sch]
2012-12-16 Chaotic changes.
    [encoders.sch, encoders2.sch, encoders3.sch, encoders4.sch, io.sch, knobboard.brd, knobboard.sch, stm32.sch]
2012-12-20 Nicer LED and note on/off handling.
2012-12-21 Some MIDI IN code. Turn off interrupts in the critical section in TCircularBuffer (not tested).
2013-06-01 Finished board layout.
    [encoders.sch, encoders2.sch, encoders3.sch, encoders4.sch, flash.sch, io.sch, knobboard.brd, knobboard.sch]
2013-06-08 Finished board CAD?
    [encoders.sch, encoders2.sch, encoders3.sch, encoders4.sch, flash.sch, io.sch, knobboard.brd, knobboard.sch]
2013-06-09 Changed to AT45 flash.
    [encoders.sch, encoders2.sch, encoders3.sch, encoders4.sch, flash.sch, io.sch, knobboard.brd, knobboard.sch]
2013-06-09 Connect display RST to VPULLUP. Fix silkscreen.
    [encoders.sch, encoders2.sch, encoders3.sch, encoders4.sch, flash.sch, io.sch, knobboard.brd, knobboard.sch]
2013-07-13 Updates to run on the new STM32F103 hardware.
2013-07-15 Flash driver (not used), task and scheduler improvements.
2015-05-10 Support running status in MIDI parser. Sysex still broken?
    [TMidiParser.cpp]
2015-05-10 Use an event class instead of a simple type, set velocity from MIDI
2015-08-02 Fix sequencer unit test
    [TSequencer.cpp]
2015-08-02 OpenOCD configuration file
    [stm32f103rc.cfg]
2015-08-02 Use interrupt driven USB communications
